cva68/ESPBreadboardRobot/hardware/schema.pdf

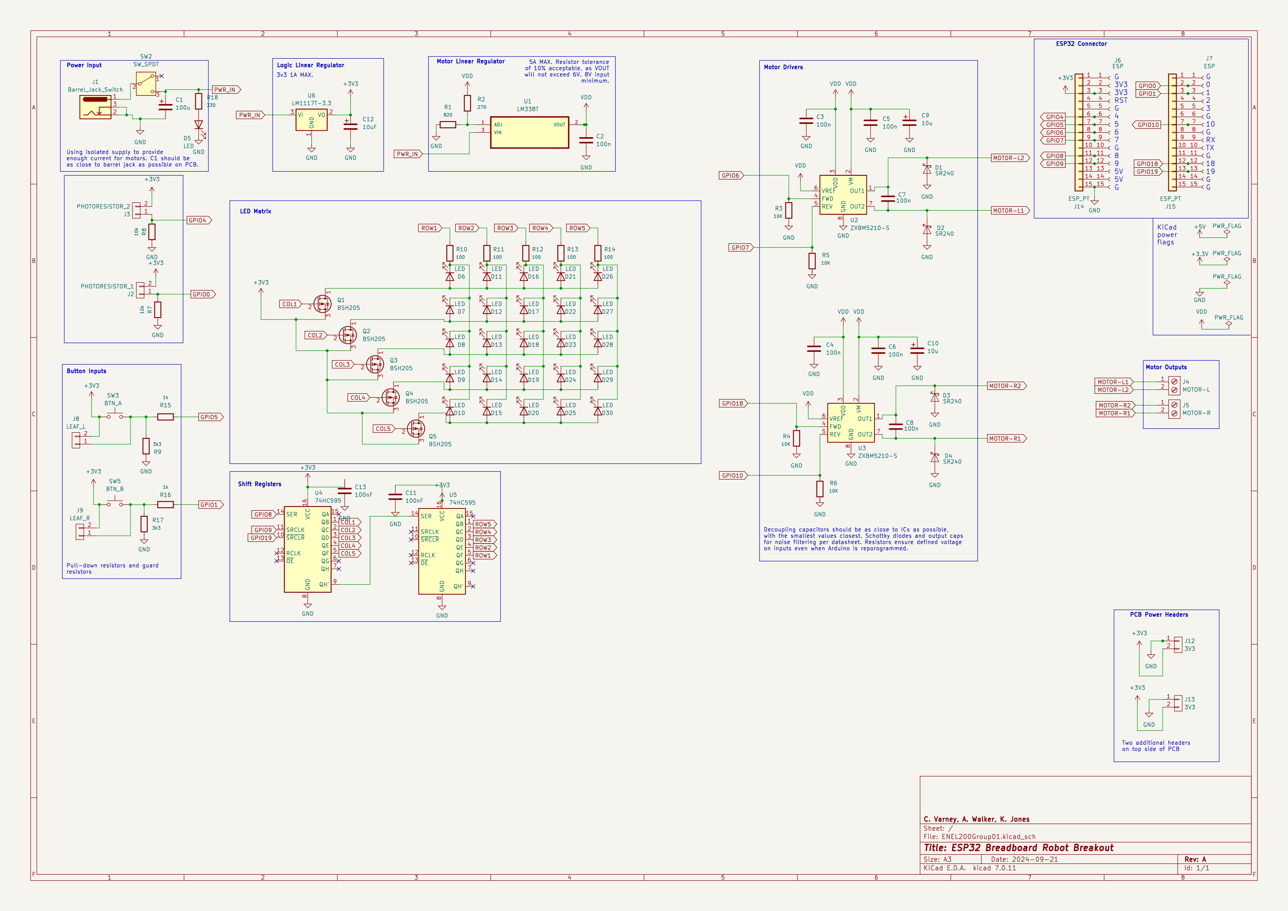
[picture p1: page 1]
