cva68/ESPBreadboardRobot/hardware/KiCad/ENEL200Group01.kicad_pcb

## KiCad design hardware/KiCad/ENEL200Group01.kicad_pcb (2024-09-24)

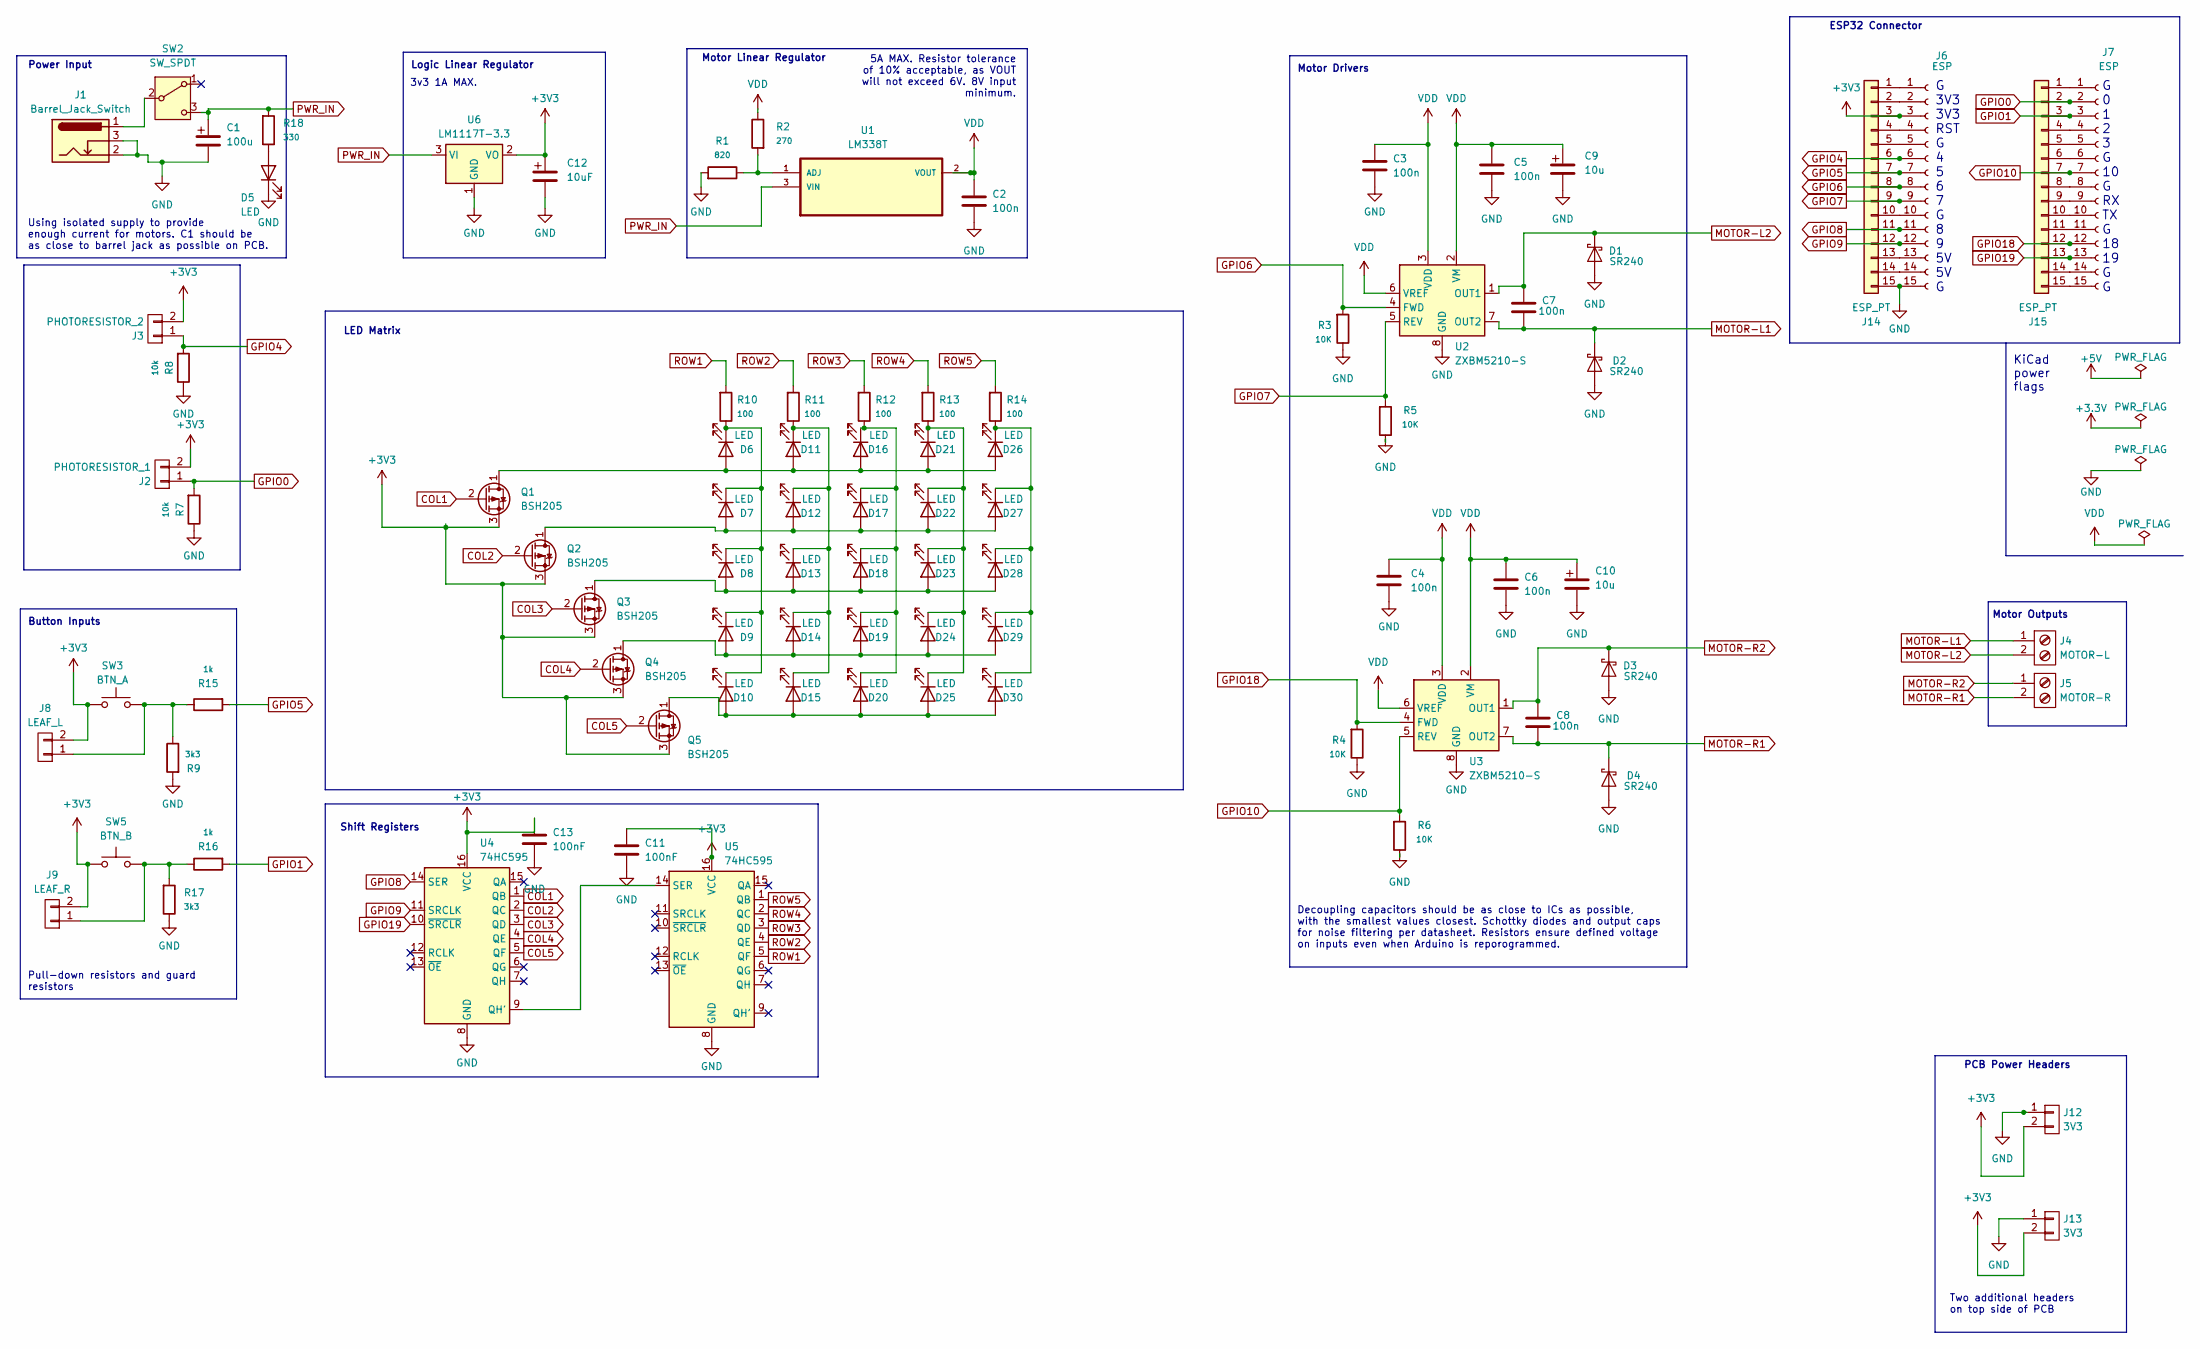
[picture p2: schematic ENEL200Group01.kicad_sch, ESP32 Breadboard Robot Breakout]

Parts:
C1: 100u; CP_Radial_D8.0mm_P3.50mm
C2, C3, C4, C5, C6, C7, C8: 100n; C_Rect_L4.6mm_W3.0mm_P2.50mm_MKS02_FKP02
C9, C10: 10u; CP_Radial_D8.0mm_P3.50mm
C11, C13: 100nF; C_Rect_L7.0mm_W2.5mm_P5.00mm
C12: 10uF; CP_Radial_D5.0mm_P2.00mm
D1, D2, D3, D4: SR240; D_DO-35_SOD27_P2.54mm_Vertical_AnodeUp
D5: LED; LED_D5.0mm
D6, D7, D8, D9, D10, D11, D12, D13, D14, D15, D16, D17, D18, D19, D20, D21, D22, D23, D24, D25, D26, D27, D28, D29, D30: LED; LED_1206_3216Metric_Pad1.42x1.75mm_HandSolder
J1: Barrel_Jack_Switch; BarrelJack_Horizontal
J2: PHOTORESISTOR_1; PinHeader_1x02_P2.54mm_Vertical
J3: PHOTORESISTOR_2; PinHeader_1x02_P2.54mm_Vertical
J4: MOTOR-L; TerminalBlock_Phoenix_MKDS-1,5-2-5.08_1x02_P5.08mm_Horizont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
J5: MOTOR-R; TerminalBlock_Phoenix_MKDS-1,5-2-5.08_1x02_P5.08mm_Horizont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
J6, J7: ESP; PinHeader_1x15_P2.54mm_Vertical
J8: LEAF_L; PinHeader_1x02_P2.54mm_Vertical
J9: LEAF_R; PinHeader_1x02_P2.54mm_Vertical
J12, J13: 3V3; PinHeader_1x02_P2.54mm_Vertical
J14, J15: ESP_PT; PinHeader_1x15_P2.54mm_Vertical
Q1, Q2, Q3, Q4, Q5: BSH205; SOT-23-3
R1: 820; R_Axial_DIN0207_L6.3mm_D2.5mm_P2.54mm_Vertical
R2: 270; R_Axial_DIN0207_L6.3mm_D2.5mm_P2.54mm_Vertical
R3, R4, R5, R6: 10K; R_Axial_DIN0207_L6.3mm_D2.5mm_P2.54mm_Vertical
R7, R8: 10k; R_Axial_DIN0207_L6.3mm_D2.5mm_P2.54mm_Vertical
R9, R17: 3k3; R_Axial_DIN0207_L6.3mm_D2.5mm_P2.54mm_Vertical
R10, R11, R12, R13, R14: 100; R_Axial_DIN0207_L6.3mm_D2.5mm_P2.54mm_Vertical
R15, R16: 1k; R_Axial_DIN0207_L6.3mm_D2.5mm_P2.54mm_Vertical
R18: 330; R_Axial_DIN0207_L6.3mm_D2.5mm_P2.54mm_Vertical
SW2: SW_SPDT; SW_Slide-03_Wuerth-WS-SLTV_10x2.5x6.4_P2.54mm
SW3: BTN_A; SW_PUSH_6mm_H5mm
SW5: BTN_B; SW_PUSH_6mm_H5mm
U1: LM338T; TO-220-3_Horizontal_TabDown
U2, U3: ZXBM5210-S; SOIC-8_3.9x4.9mm_P1.27mm
U4, U5: 74HC595; SOIC-16_4.55x10.3mm_P1.27mm
U6: LM1117T-3.3; TO-220-3_Horizontal_TabDown

Connections:
+3V3: C11.1, C12.1, C13.1, J2.2, J3.2, J6.3, J8.2, J9.2, J12.2, J13.2, J14.3, Q1.3 (S), Q2.3 (S), Q3.3 (S), Q4.3 (S), Q5.3 (S), SW3.1, SW5.1, U4.16 (VCC), U5.16 (VCC), U6.2 (VO)
COL1: Q1.2 (G), U4.1 (QB)
COL2: Q2.2 (G), U4.2 (QC)
COL3: Q3.2 (G), U4.3 (QD)
COL4: Q4.2 (G), U4.4 (QE)
COL5: Q5.2 (G), U4.5 (QF)
GND: C1.2, C2.2, C3.2, C4.2, C5.2, C6.2, C9.2, C10.2, C11.2, C12.2, C13.2, D1.2 (A), D2.2 (A), D3.2 (A), D4.2 (A), D5.1 (K), J1.2, J1.3, J6.15, J12.1, J13.1, J14.15, R1.1, R3.2, R4.2, R5.2, R6.2, R7.2, R8.2, R9.1, R17.2, U2.8 (GND), U3.8 (GND), U4.8 (GND), U5.8 (GND), U6.1 (GND)
GPIO0: J2.1, J7.2, J15.2, R7.1
GPIO1: J7.3, J15.3, R16.1
GPIO4: J3.1, J6.6, J14.6, R8.1
GPIO5: J6.7, J14.7, R15.1
GPIO6: J6.8, J14.8, R3.1, U2.4 (FWD)
GPIO7: J6.9, J14.9, R5.1, U2.5 (REV)
GPIO8: J6.11, J14.11, U4.14 (SER)
GPIO9: J6.12, J14.12, U4.11 (SRCLK)
GPIO10: J7.7, J15.7, R6.1, U3.5 (REV)
GPIO18: J7.12, J15.12, R4.1, U3.4 (FWD)
GPIO19: J7.13, J15.13, U4.10 (~SRCLR)
MOTOR-L1: C7.2, D2.1 (K), J4.1, U2.7 (OUT2)
MOTOR-L2: C7.1, D1.1 (K), J4.2, U2.1 (OUT1)
MOTOR-R1: C8.2, D4.1 (K), J5.2, U3.7 (OUT2)
MOTOR-R2: C8.1, D3.1 (K), J5.1, U3.1 (OUT1)
unnamed: D5.2 (A), R18.2
unnamed: D10.2 (A), D15.2 (A), D20.2 (A), D25.2 (A), D30.2 (A), Q5.1 (D)
unnamed: D6.1 (K), D7.1 (K), D8.1 (K), D9.1 (K), D10.1 (K), R10.2
unnamed: D6.2 (A), D11.2 (A), D16.2 (A), D21.2 (A), D26.2 (A), Q1.1 (D)
unnamed: D11.1 (K), D12.1 (K), D13.1 (K), D14.1 (K), D15.1 (K), R11.2
unnamed: D7.2 (A), D12.2 (A), D17.2 (A), D22.2 (A), D27.2 (A), Q2.1 (D)
unnamed: D8.2 (A), D13.2 (A), D18.2 (A), D23.2 (A), D28.2 (A), Q3.1 (D)
unnamed: D9.2 (A), D14.2 (A), D19.2 (A), D24.2 (A), D29.2 (A), Q4.1 (D)
unnamed: D16.1 (K), D17.1 (K), D18.1 (K), D19.1 (K), D20.1 (K), R12.2
unnamed: D21.1 (K), D22.1 (K), D23.1 (K), D24.1 (K), D25.1 (K), R13.2
unnamed: D26.1 (K), D27.1 (K), D28.1 (K), D29.1 (K), D30.1 (K), R14.2
unnamed: J8.1, R9.2, R15.2, SW3.2
unnamed: J9.1, R16.2, R17.1, SW5.2
unnamed: J6.1, J14.1
unnamed: J6.2, J14.2
unnamed: J6.4, J14.4
unnamed: J6.5, J14.5
unnamed: J6.10, J14.10
unnamed: J6.13, J14.13
unnamed: J6.14, J14.14
unnamed: J7.1, J15.1
unnamed: J7.4, J15.4
unnamed: J7.5, J15.5
unnamed: J7.6, J15.6
unnamed: J7.8, J15.8
unnamed: J7.9, J15.9
unnamed: J7.10, J15.10
unnamed: J7.11, J15.11
unnamed: J7.14, J15.14
unnamed: J7.15, J15.15
unnamed: J1.1, SW2.2 (B)
unnamed: R1.2, R2.1, U1.1 (ADJ)
unnamed: U4.9 (QH'), U5.14 (SER)
PWR_IN: C1.1, R18.1, SW2.3 (C), U1.3 (VIN), U6.3 (VI)
ROW1: R10.1, U5.5 (QF)
ROW2: R11.1, U5.4 (QE)
ROW3: R12.1, U5.3 (QD)
ROW4: R13.1, U5.2 (QC)
ROW5: R14.1, U5.1 (QB)
VDD: C2.1, C3.1, C4.1, C5.1, C6.1, C9.1, C10.1, R2.2, U1.2 (VOUT), U2.2 (VM), U2.3 (VDD), U2.6 (VREF), U3.2 (VM), U3.3 (VDD), U3.6 (VREF)

Notes on the sheet:
5A MAX. Resistor tolerance of 10% acceptable, as VOUT will not exceed 6V. 8V input minimum.
Motor Outputs
Motor Linear Regulator
G 3V3 3V3 RST G 4 5 6 7 G 8 9 5V 5V G
Button Inputs
Two additional headers on top side of PCB
3v3 1A MAX.
LED Matrix
KiCad power flags
Motor Drivers
Logic Linear Regulator
G 0 1 2 3 G 10 G RX TX G 18 19 G G
Pull-down resistors and guard resistors
Shift Registers
Decoupling capacitors should be as close to ICs as possible, with the smallest values closest. Schottky diodes and output caps for noise filtering per datasheet. Resistors ensure defined voltage on inputs even when Arduino is reporogrammed.
PCB Power Headers
ESP32 Connector
Using isolated supply to provide enough current for motors. C1 should be as close to barrel jack as possible on PCB.
Power Input

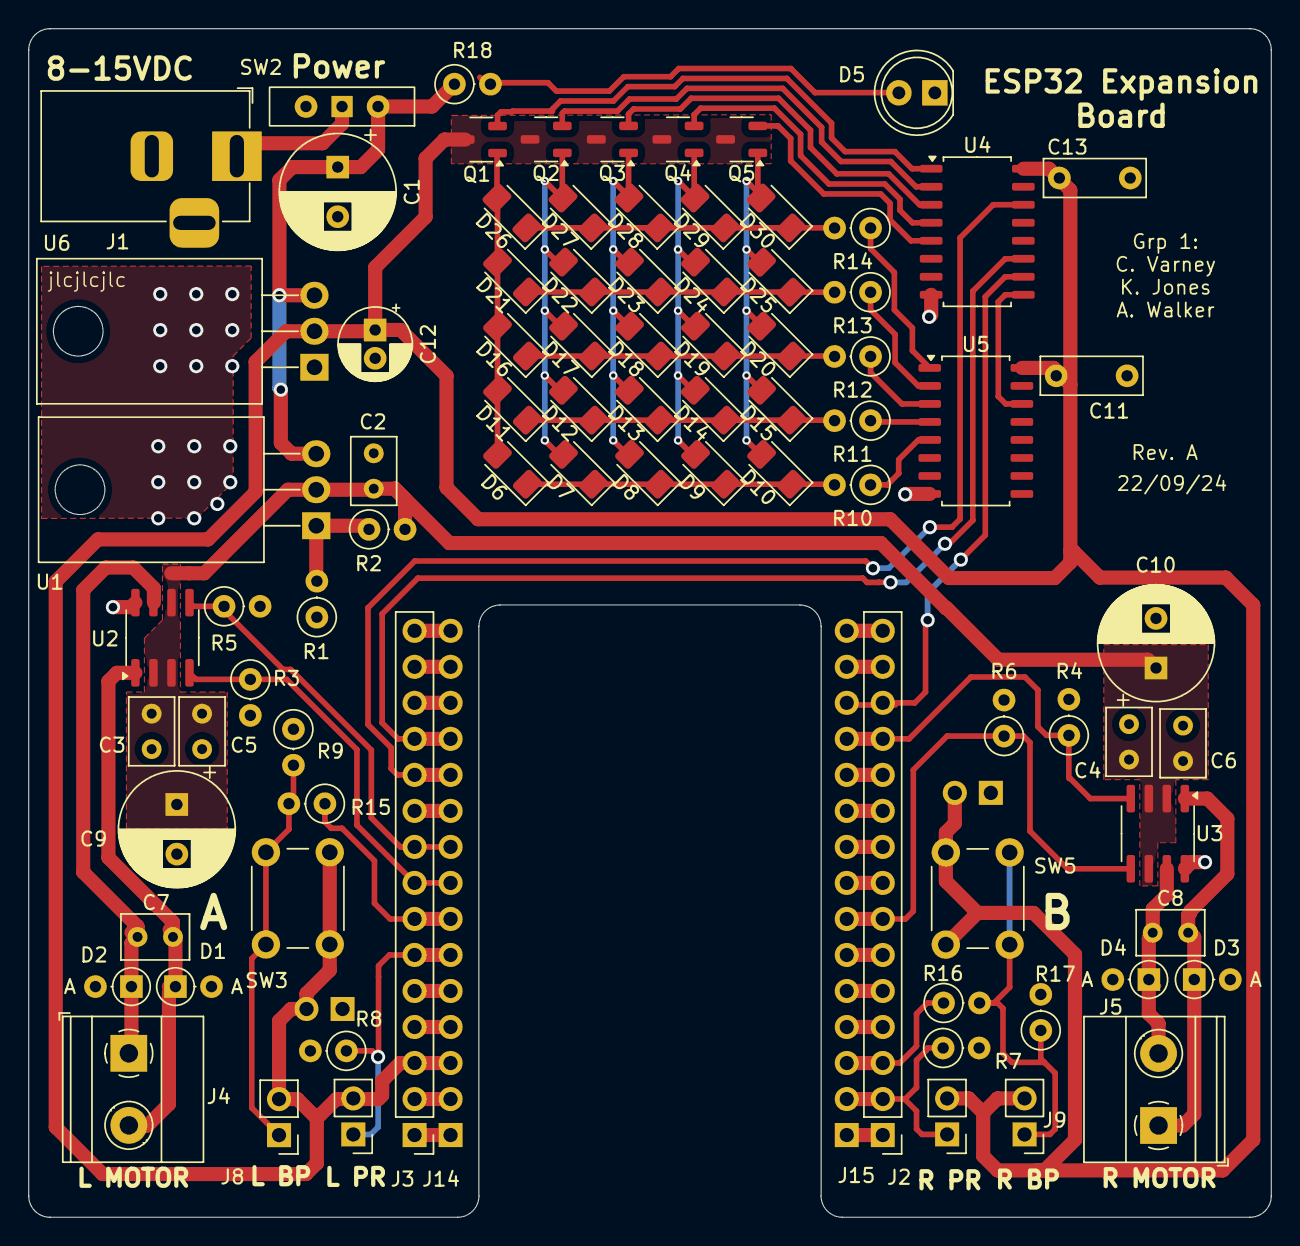
[picture p3: board ENEL200Group01.kicad_pcb from above]

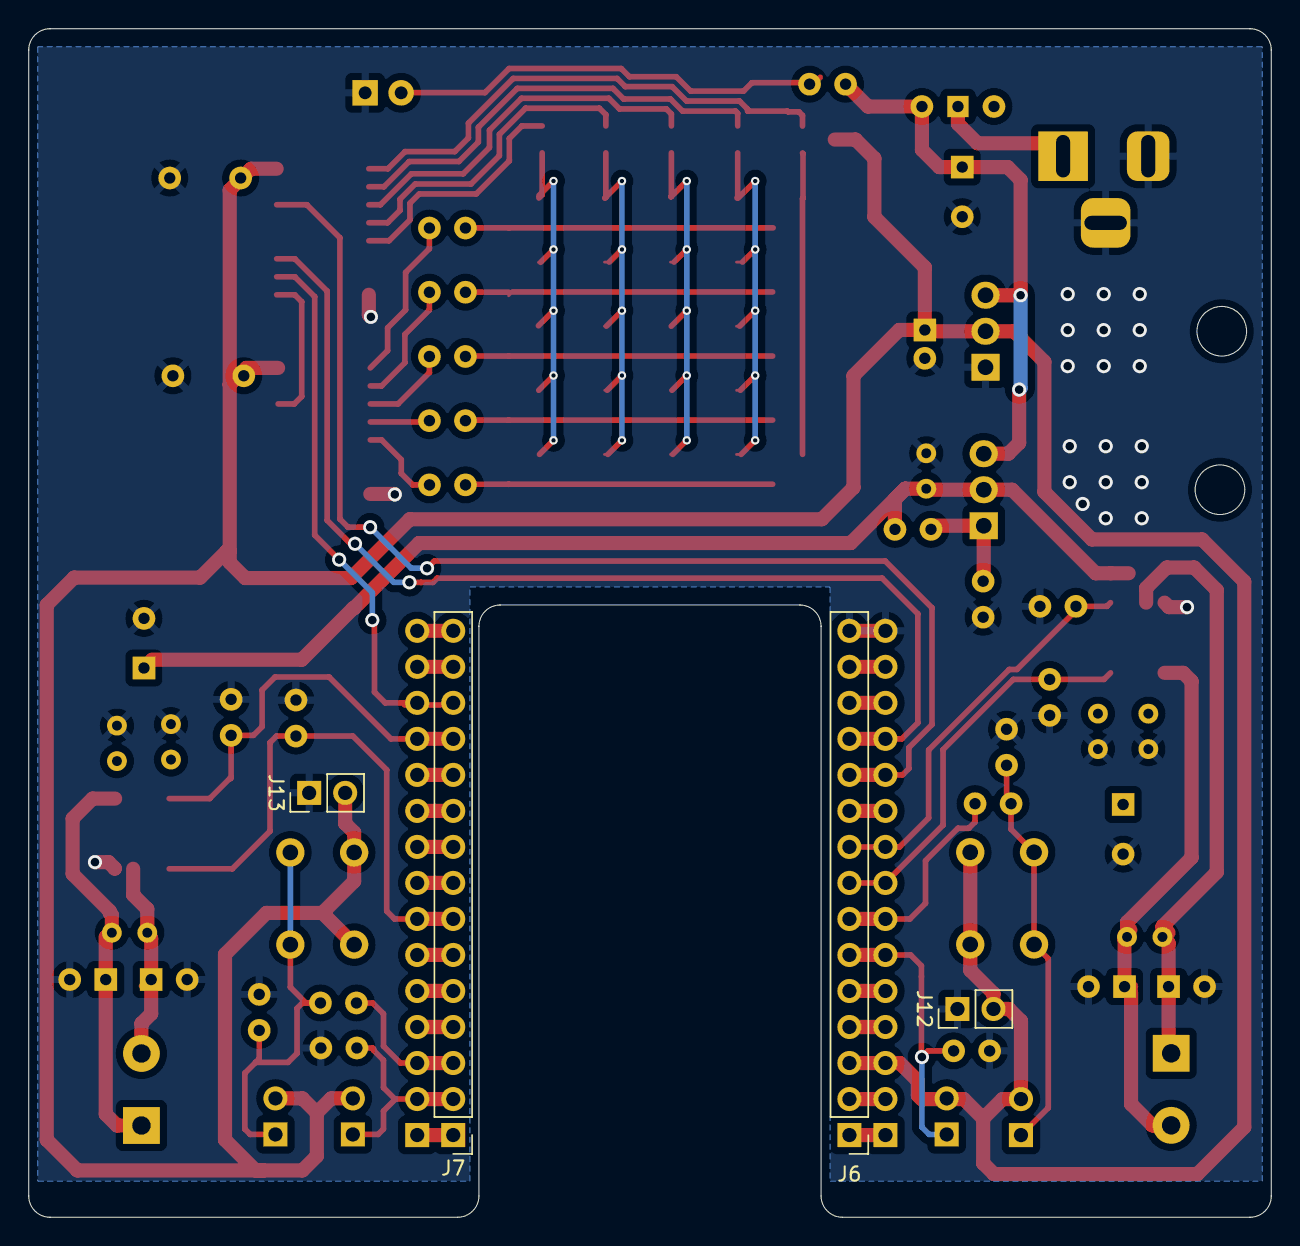
[picture p4: board ENEL200Group01.kicad_pcb from below]

Board: 2 copper layers, 87.6 x 83.8 mm, 88 parts (4 on the bottom side), 62 nets.
