cva68/ESPBreadboardRobot/(commit log)

2024-09-19 Initial PCB design
    [KiCad.kicad_pcb, KiCad.kicad_sch]
2024-09-19 Added shift registers, finished LED matrix
2024-09-21 Finished Rev A schematic
    [KiCad.kicad_sch]
2024-09-21 Added NC markers, title and date
    [KiCad.kicad_sch]
2024-09-22 PCB Revision A Created
    [KiCad.kicad_pcb, KiCad.kicad_sch]
2024-09-22 fixed kahus clever commit
    [KiCad.kicad_pcb, KiCad.kicad_sch]
2024-09-22 fixed connors clever commit
    [KiCad.kicad_pcb, KiCad.kicad_sch]
2024-09-24 final pcb rev
    [ENEL200Group01.kicad_pcb, ENEL200Group01.kicad_sch, KiCad.kicad_pcb]
2024-10-01 restructured, added schema and pcb layout
    [ENEL200Group01.kicad_pcb, ENEL200Group01.kicad_sch]
2024-10-05 Restructured, added LED test script
2024-10-06 added input class and motor driver class
2024-10-06 Initial testing of the LED matrix software
2024-10-06 Updated LED code
2024-10-06 threading update display function
2024-10-06 Fixed missing self reference
    [main.py]
2024-10-07 changed led to send tuples
2024-10-07 More LED testing
2024-10-07 led plot
2024-10-07 LED Testing
2024-10-07 plot, unplot, toggle functions added to led
2024-10-08 Fixed LED plotting from MakeCode pattern, removed functions not implemented
    [main.py]
